eacandelas/BENOTL/README.md

# The Badge of the Lands

## NOTA: 
Este proyecto ha dejado de recibir soporte, pero recuerde es un proyecto opensource puede tomarlo y modificarlo a su gusto, gracias por el apoyo para crear este proyecto aprendimos demasiado y ahora tenemos nuevos proyectos con badges, esperalos pronto

Badge Electronico No Oficial para Talent Land México 2018.
[Hackday project](https://hackaday.io/project/58276-the-badge-of-the-lands)

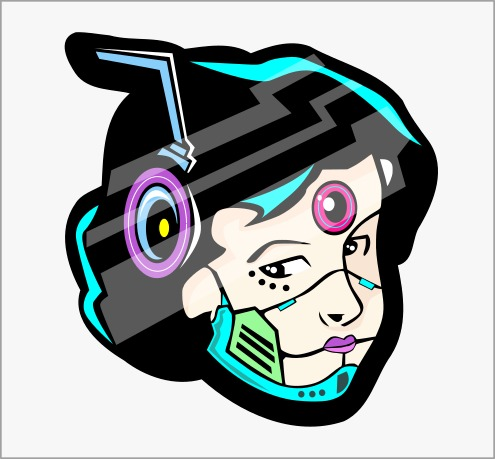
[picture p1: BENOTL-Diseno/SVG_PCB/Chica/Chica.png]
Chica


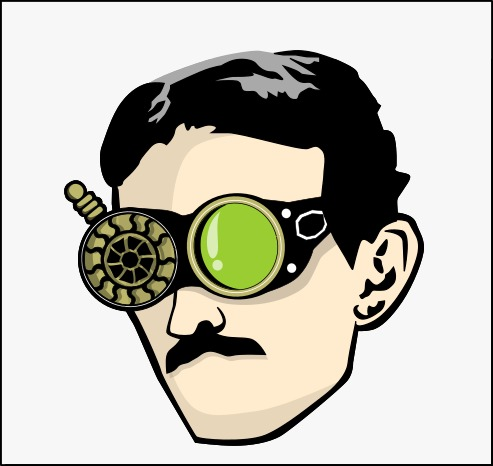
[picture p2: BENOTL-Diseno/SVG_PCB/Tesla/Tesla.png]
Robot


## Caracteristicas

- Basado en el modulo WIFi ESP8266
- 12 Leds WS2812B
- Pantalla OLED 128x64
- Puerto USB
- Programador incluido

## Esquematico
Diagrama en PDF y archivos para KiCad

- [Esquematico PDF](https://github.com/greenoneo0/BENOTL/blob/master/BENOTL-HW/Chica/talentBadge.pdf)

## Agradecemos a nuestros patrocinadores
- [Mouser Electronics](https://www.mouser.mx/)
- [PCBWay](https://www.pcbway.com/setinvite.aspx?inviteid=53690)
- [Wurth Electronics](http://www.we-online.com/web/en/wuerth_elektronik/start.php)
- [Espressif](https://www.espressif.com/)
 
## Autores
By:

@gsreynaga      - Layout y routing.

@ForeverWero    - Footprints y layout

@elmundoverdees - Esquematico y BOM

@armando_are    - Diseño

@sabasacustico  - PM y logistica.

## Pagina del proyecto

[Pagina del proyecto en Hackday](https://hackaday.io/project/58276-the-badge-of-the-lands)
 
## Licencia
Firmware bajo una licencia MIT. ver el archivo LICENSE para mas información.

Hardware lanzado bajo una licencia CERN Open Hardware Licence v1.2. Ver el archivo LICENSE_HARDWARE para mas información.
