eacandelas/BENOTL/BENOTL-Diseno/README.md

Folder para items relacionados con diseño para el Badge Electronico No Oficial de Talent Land 2018
