eacandelas/BENOTL/BENOTL-FW/README.md

Folder para items relacionados con firmware para el Badge Electronico No Oficial de Talent Land 2018
