eacandelas/BENOTL/BENOTL-Diseno/SVG_PCB/Robot/Robot.png

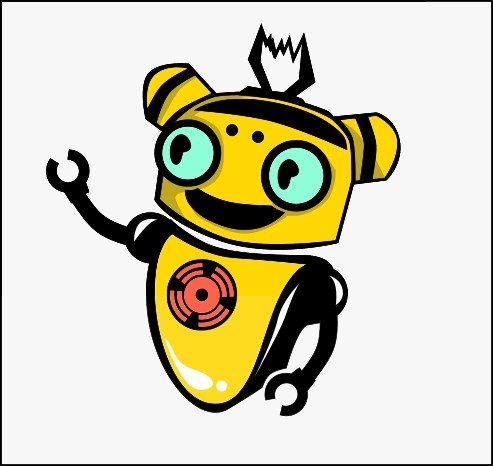
BENOTL-Diseno/SVG_PCB/Robot/Robot.png
