eacandelas/BENOTL/BENOTL-HW/Chica/chicaTalent3DRouteo1.png

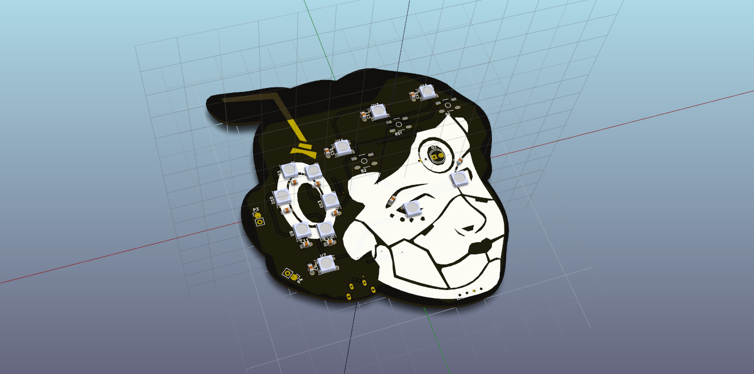
BENOTL-HW/Chica/chicaTalent3DRouteo1.png
