eacandelas/BENOTL/BENOTL-HW/Chica/chicaTalent3DRouteo2.png

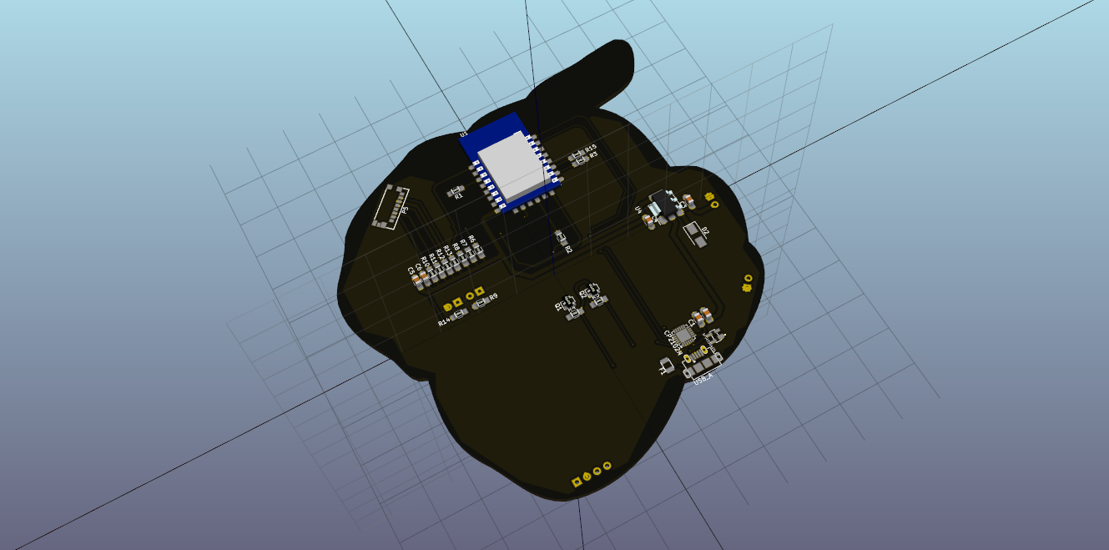
BENOTL-HW/Chica/chicaTalent3DRouteo2.png
