eacandelas/BENOTL/BENOTL-HW/Chica/chicaTalentPrerouteoB.png

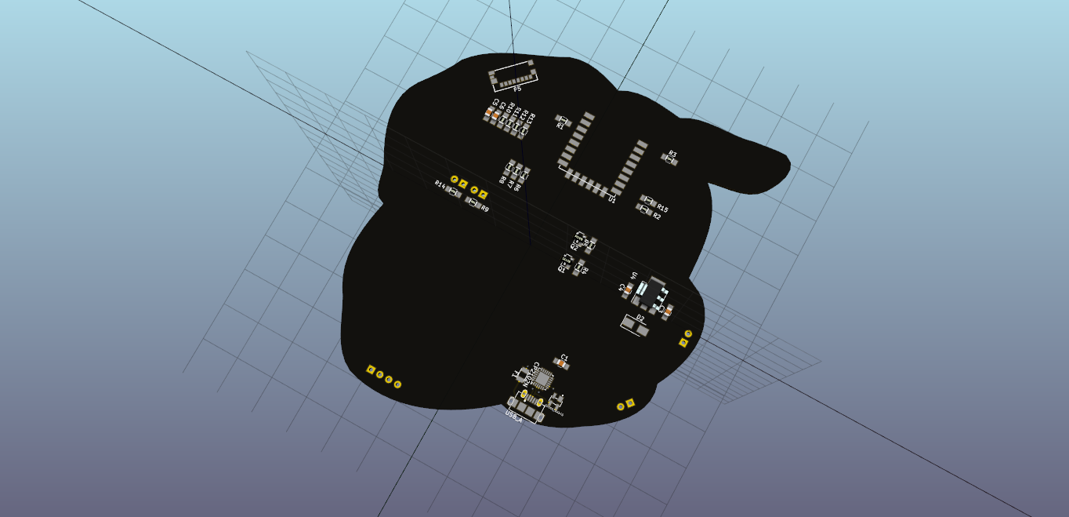
BENOTL-HW/Chica/chicaTalentPrerouteoB.png
