eacandelas/BENOTL/BENOTL-HW/Chica/chicaTalentPrerouteoF.png

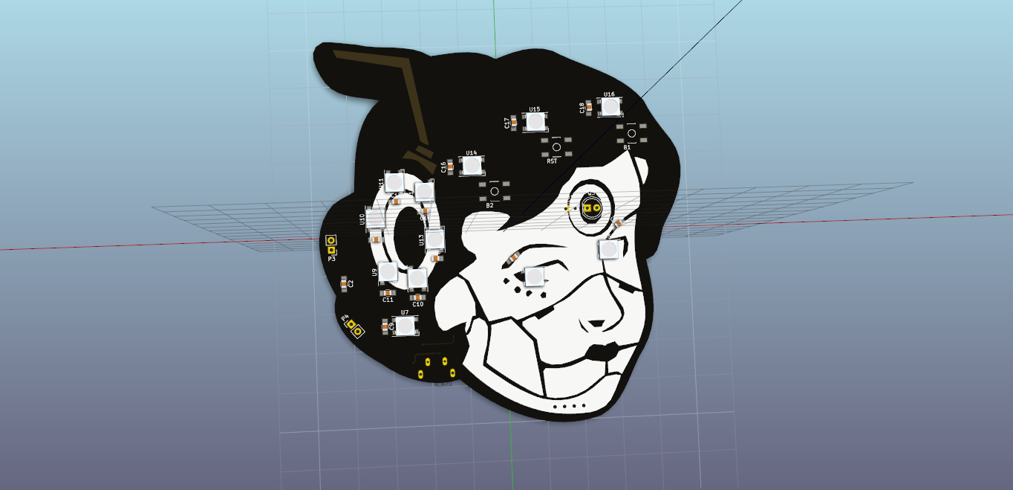
BENOTL-HW/Chica/chicaTalentPrerouteoF.png
