eacandelas/BENOTL/pcbway.png

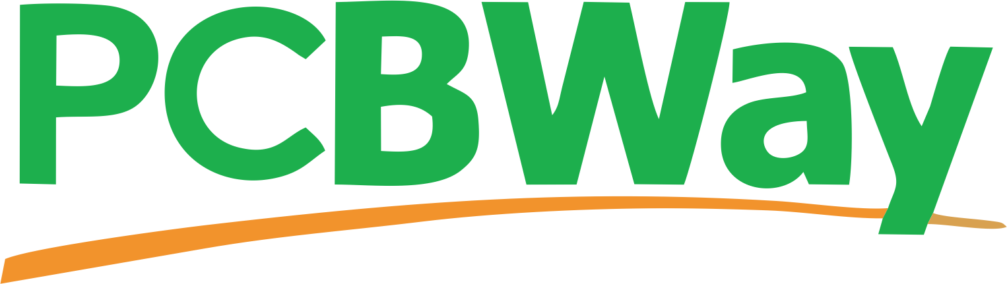
pcbway.png
