eacandelas/BENOTL/BENOTL-HW/Chica/talentBadge.pdf

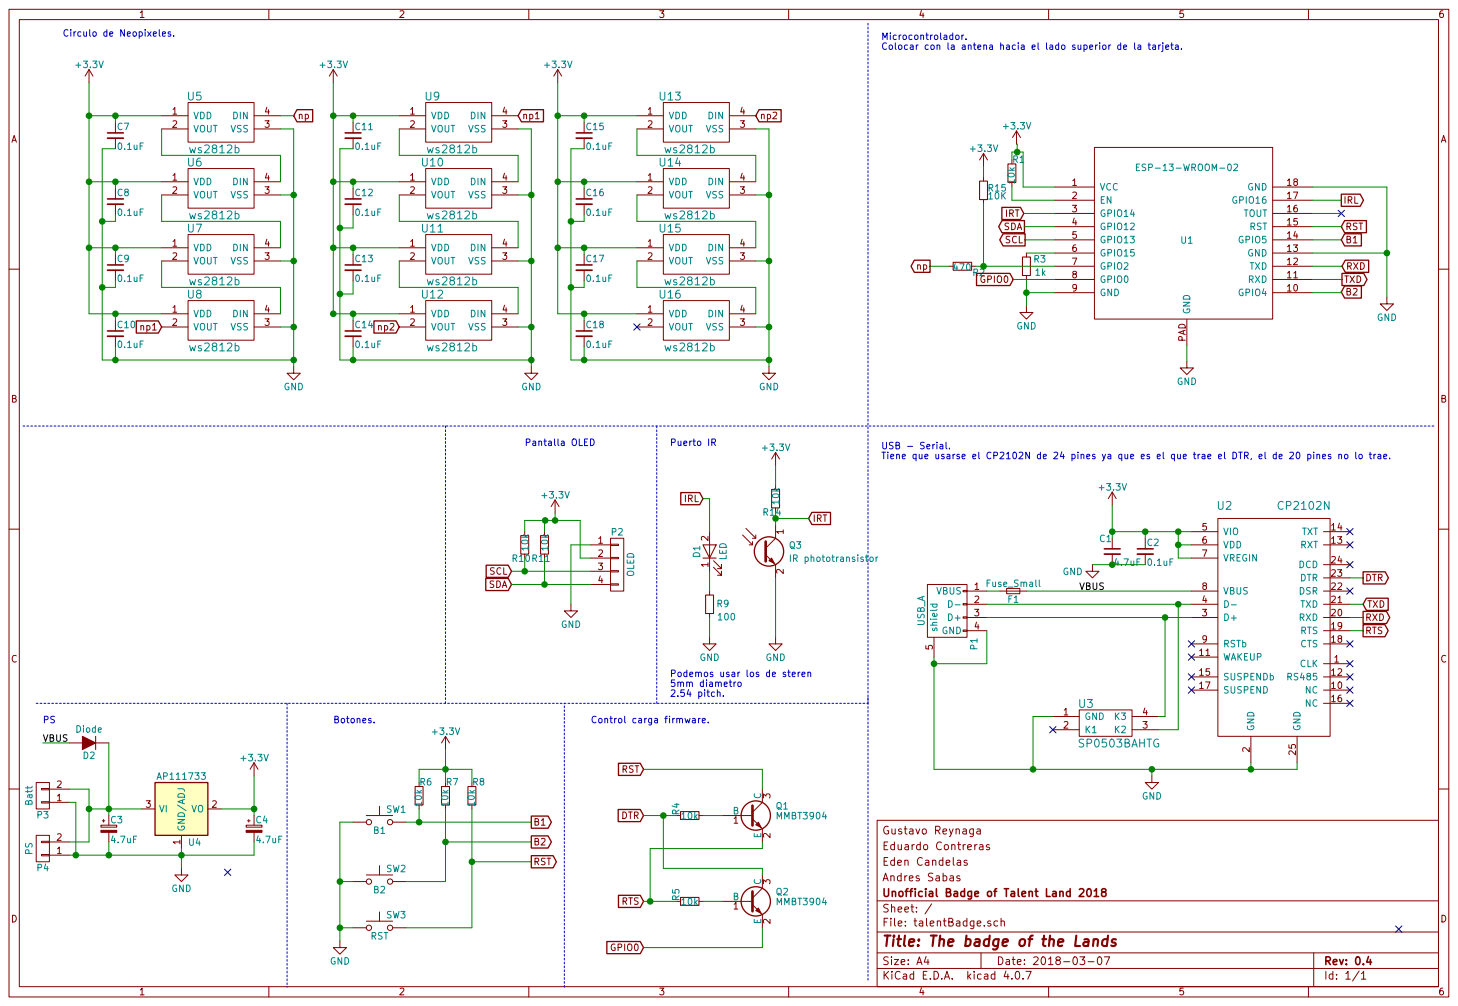
[picture p9: page 1]

Microcontrolador. Colocar con la antena hacia el lado superior de la tarjeta.

2 D+ 3 D- 4 VIO 5 VDD 6 VREGIN 7 VBUS 8 RSTb 9 NC 10 RXD 20 WAKEUP 11 TXD 21 RS485 12 DSR 22 RXT 13 DTR 23 TXT 14 DCD 24 SUSPENDb 15 GND 25 NC 16 SUSPEND 17 CTS 18 RTS 19 U2 CP2102N

File: talentBadge.sch Sheet: / Unofficial Badge of Talent Land 2018 Andres Sabas Eden Candelas Eduardo Contreras Gustavo Reynaga SW1 B1 GND

Id: 1/1 Title: The badge of the Lands
