eacandelas/BENOTL/makers mex.png

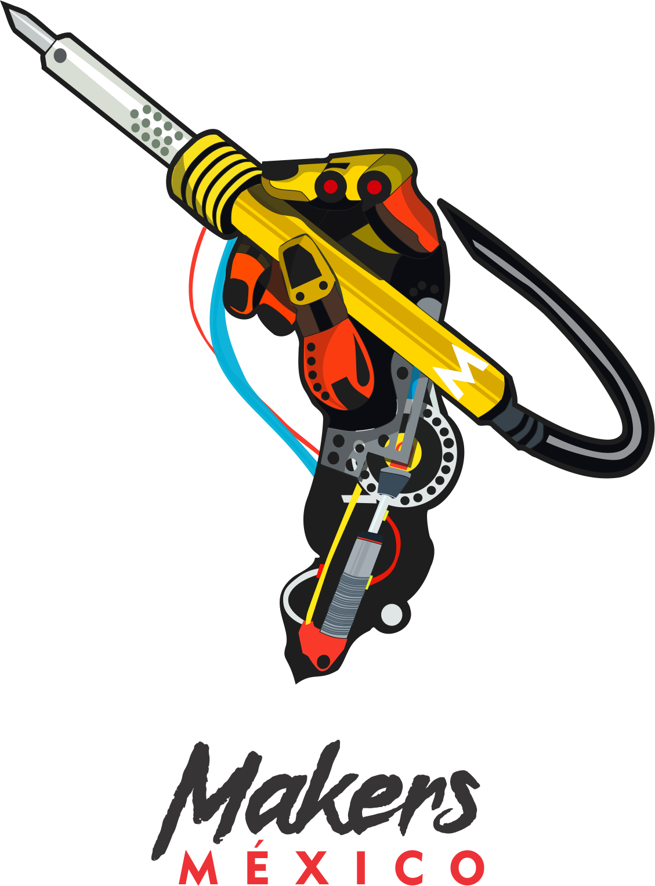
makers mex.png
