eacandelas/BENOTL/(threads)

Thread 4 (2018-09-09):

Bug Baterias Invertidas

insanitus, 2018-09-09:
Hola;

 ¿Ya corrigieron el **bug** de poner las _baterias invertidas_ para que funcione la badge?

 Saludos

insanitus, 2019-07-20:
Hola, ¿Como van? :)

sabas1080, 2019-07-24:
@wero1414 @greenoneo0 hubo una correcion?

greenoneo0, 2019-07-24:
Ninguna corrección.
El estatus actual es que ya tenemos los stenciles que faltaban.
Estamos esperando un huevo para poderlos meter a re manufactura (quitar los componentes dañados y resoldar) principalmente los usb/serial. Y soldar las tarjetas que vienen vírgenes.

insanitus, 2019-09-25:
¿Entonces @greenoneo0  crees que llevan un 48% de avance?

insanitus, 2021-02-04:
> Ninguna corrección.
> El estatus actual es que ya tenemos los stenciles que faltaban.
> Estamos esperando un huevo para poderlos meter a re manufactura (quitar los componentes dañados y resoldar) principalmente los usb/serial. Y soldar las tarjetas que vienen vírgenes.

Hola @eacandelas ¿Como va el proyecto?, ¿En que andan atorados? @sabas1080

sabas1080, 2021-04-28:
Corregido error de baterías en las versiones que se mandaron a produccion Chica y Tesla

Closed 2021-04-28.

Thread 6 (2021-04-28):

¿Y el firmware?

insanitus, 2021-04-28:
Hola buen día;

Revisando parte del git de las badge, noto que, _el apartado del firmware esta totalmente vacio_

`https://github.com/eacandelas/BENOTL/tree/master/BENOTL-FW`

De antemano, les agredeceria, si lo pudieran subir (n_n)

Saludos

@wero1414 @sabas1080 @eacandelas @ElectronicCats

sabas1080, 2021-04-28:
Añadido ejemplo para neopixeles

Closed 2021-04-28.

Thread 7 (2021-04-28):

Actualizar el Firmware para que funcione el esp

insanitus, 2021-04-28:
Hola, buen día;

 De momento el Firmware tiene un funcionamiento limitado, ya que única y exclusivamente solo han;
```

Añadido ejemplo para neopixeles

_Originally posted by @sabas1080 in https://github.com/eacandelas/BENOTL/issues/6#issuecomment-828137069_
```

Más la parte del esp queda fuera de funcionamiento, por falta de código, y acorde a los objetivos que se habían puesto previamente;

```
Funciones:
- Intercambio de credenciales IR y Web
- Funcionalidad de TVGBone
- Mesh

También se puede usar para:
- WiFi Spoofing
- WiFi deauthentication
```

Son las funciones que hacen falta en el código del firmware.

¿Y este es el datahseet correspondiente al esp que utiliza la badge?
https://www.espressif.com/sites/default/files/documentation/0c-esp-wroom-02_datasheet_en.pdf

 De antemano agradezco el tiempo que se toman, en leer y atender este issue.

@wero1414 @sabas1080 @eacandelas @ElectronicCats

Saludos

sabas1080, 2021-04-28:
Hay varios proyectos en los que te puedes basar y crear lo que mencionas

https://github.com/lspoplove/Deauther-Project
https://github.com/SpacehuhnTech/esp8266_deauther
https://github.com/SpacehuhnTech/WiFiDuck
https://github.com/spacehuhn/esp8266_beaconSpam
https://github.com/spacehuhn/PacketMonitor
https://github.com/spacehuhn/ArduinoPcap
https://github.com/spacehuhn/wifi_ducky
https://github.com/spacehuhn/wifi_keylogger
https://github.com/SpacehuhnTech/Huhnitor

Las partes involucradas no podemos dar más soporte a este proyecto por tiempo y los recursos que se destinaron para crearlo, pero el proyecto tiene todo lo necesario para adaptarlo y hacerlo funcionar

Closed 2021-04-28.
