eacandelas/BENOTL/(commit log)

2018-02-17 Esquematico
    Primera revision del esquematico.
    Todos los componentes continen numero de parte y referencia a esquematicos.
    [talentBadge.kicad_pcb, talentBadge.sch]
2018-02-17 READMEs
    Añadidos readmes en folders para su post.
2018-02-17 Rename components
    [talentBadge.sch]
2018-02-19 Added footprints library
2018-02-19 Fix neopixel rail and CvPCB
    Associated all schematics with its footprints
    [talentBadge.sch]
2018-02-19 Add provissional footprints
    For IR and BATT and PS
    [talentBadge.sch]
2018-02-19 Fix SD_Card footprint
    Change the silkscreen name
2018-02-19 Add netlist
    added netlist 0.1v with the provissional footprints
2018-02-19 PCB file with all footprints
    [talentBadge.kicad_pcb]
2018-02-19 Creacion de carpetas para cada PCB
    [talentBadge.kicad_pcb, talentBadge.sch]
2018-02-19 Archivos Layout para PCB Chica
    [talentBadge.kicad_pcb, talentBadge.sch]
2018-02-19 Cambios Archivos Layout PCB Chica
    [talentBadge.kicad_pcb]
2018-02-19 Changes Tesla Layout Files
    [talentBadge.kicad_pcb]
2018-02-19 Changes Robot Layout files
    [talentBadge.kicad_pcb, talentBadge.sch]
2018-02-19 Changes Cat Layout files
    [talentBadge.kicad_pcb]
2018-02-20 Add resistor to GPIO2
    [talentBadge.sch]
2018-02-20 Not connect
    [talentBadge.sch]
2018-02-27 added footprint ESP8266
2018-02-27 Routeo y layout de chica - incompleto.
    Tuve que cambiar el grid del schematico por que en la seccion del esp estabamovido.
    [talentBadge.kicad_pcb, talentBadge.sch]
2018-02-27 Routeo Chica completo
    Se cambio pin vcc y gnd en conector oled de posicion ya que estaban al reves.
    [talentBadge.kicad_pcb, talentBadge.sch]
2018-03-01 Add no conection
    [talentBadge.sch]
2018-03-01 Update schematic robot
    [talentBadge.sch]
2018-03-03 Change footprint ESP8266
    [talentBadge.sch]
2018-03-03 Routeo para revision
    [talentBadge.kicad_pcb]
2018-03-03 acomodo de etiquetas
    [talentBadge.kicad_pcb]
2018-03-04 Update ESP8266 footprint
2018-03-04 Actualizado acomodo de footprints
    [talentBadge.kicad_pcb, talentBadge.sch]
2018-03-04 All tracks completed
    [talentBadge.kicad_pcb]
2018-03-04 Todas las pistas conectadas, y vias para tierras
    [talentBadge.kicad_pcb]
2018-03-04 Fix non-copper area ESP8266
    [talentBadge.kicad_pcb]
2018-03-04 Arreglos menores
    [talentBadge.kicad_pcb]
2018-03-04 Arreglo de pines de OLED
    [talentBadge.kicad_pcb, talentBadge.sch]
2018-03-04 Medidas de OLED
    [talentBadge.kicad_pcb]
2018-03-05 Fix capacitor de tantalio, pad salido de PCB
    [talentBadge.kicad_pcb, talentBadge.sch]
2018-03-05 Actualizado metadata de C5
    [talentBadge.sch]
2018-03-05 Update footprint ESP8266
2018-03-05 Update C4, C3 y C5
    [talentBadge.kicad_pcb, talentBadge.sch]
2018-03-05 Reglas de Gerbers
    [talentBadge.kicad_pcb]
2018-03-05 Update PCB
    [talentBadge.kicad_pcb]
2018-03-05 creada carpeta de pretty comun
2018-03-05 Agregado logo de patrocinadores
2018-03-05 Agregado logos robot
    [talentBadge.kicad_pcb]
2018-03-05 medio fixes
    [talentBadge.kicad_pcb]
2018-03-05 Agregado logos Wurth y Makers a Robot
    [talentBadge.kicad_pcb]
2018-03-05 Agregados logos chica
    [talentBadge.kicad_pcb]
2018-03-06 Fix footprint logo makers
2018-03-06 Agregado fix logo makers
    [talentBadge.kicad_pcb]
2018-03-06 Add logos
    [talentBadge.kicad_pcb]
2018-03-06 Add holder hole and extend the battery pins
    [talentBadge.kicad_pcb]
2018-03-07 Agregado footprint ESP13-WROOM-02
2018-03-08 R3 y R2 agregado al BOM
    [talentBadge.sch]
2018-03-08 Cambiado ESP8266 a ESP-WROOM-02
    [talentBadge.sch]
2018-03-08 Vinculado footprint ESP-WROOM-02
    [talentBadge.sch]
2018-03-08 Removido diagrama SD
    [talentBadge.sch]
2018-03-08 Fix bugs, Change ESP8266 footprint
    [talentBadge.kicad_pcb]
2018-03-08 Non copper zone added
    [talentBadge.kicad_pcb]
2018-03-08 bugs fixes
    [talentBadge.kicad_pcb]
2018-03-09 Chica update
    Actualizados caps C3 y C3
    Cambio de silk antena
    Cambio wroom.
    Re routeo,
    Cambio orientacion lcd
    [talentBadge.kicad_pcb, talentBadge.sch]
2018-03-09 Agregado logo mouser
    [talentBadge.kicad_pcb]
2018-03-09 Agregado KeyStone_2479
    [talentBadge.kicad_pcb, talentBadge.sch]
2018-03-09 Add battery holder
    [talentBadge.kicad_pcb]
2018-03-10 Fix battery holder hole
    [talentBadge.kicad_pcb]
2018-03-12 Chica - battery
    Se agrega holders para baterias AAA.
    Se mueven transistores de programacion y las resistencias de los leds ir.
    Pantalla principal muestra 1 unconnected, DRC muestra no unconected.
    [talentBadge.kicad_pcb, talentBadge.sch]
2018-03-12 Chica - I2C pullupt
    Se agregan pullups a linea i2c para display.
    [talentBadge.kicad_pcb, talentBadge.sch]
2018-03-12 Chica - check
    Se marcaron todas las opciones en render.
    [talentBadge.kicad_pcb]
2018-03-12 I2C resistor -tesla
    [talentBadge.kicad_pcb, talentBadge.sch]
2018-03-12 Check schematic and footprints
    [talentBadge.kicad_pcb, talentBadge.sch]
2018-04-02 Schematic general
2018-09-09 Add BOM CSV
    [talentBadge.csv]
2021-04-28 Fix Battery footprint
    [talentBadge-2021-04-27-23-41-51.sch, talentBadge.kicad_pcb]
2021-04-28 gitignore and kicad 5
2021-04-28 Incomplete versions removed
    [talentBadge.kicad_pcb, talentBadge.sch]
2021-04-28 Update schematic chica kicad5
    [talentBadge-2021-04-27-23-52-17.sch, talentBadge.sch]
